jp112sdl/WemosD1_HomeMatic_Helligkeitssensor/Images/CCU_VariableNeu.png

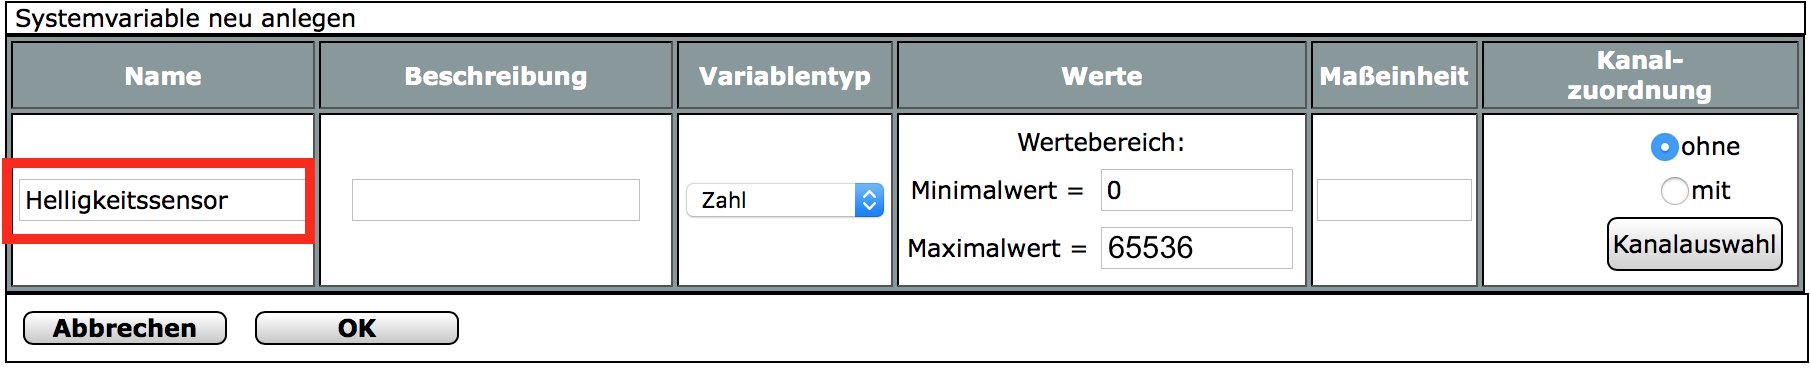
Images/CCU_VariableNeu.png
