jp112sdl/WemosD1_HomeMatic_Helligkeitssensor/(threads)

Thread 1 (2018-02-01):

WemosD1 HomeMatic mit Bmp180 Luftdruck (&Temperatur)

elbman, 2018-02-01:
Hallo,

finde dein WemosD1 Projekt mit BH1750 Helligkeitssensor über I2C genial und habe es bereits nachgebaut.

Perfekt wäre es, wenn es alternativ auch eine Version für den Luftdruck- und Temperatursensor BMP180 gäbe.

Die Info über den aktuellen Luftdruck fehlt vielen in der Homematic noch bei den Wetterdaten und lässt sich ja leider nicht als einzelner Sensor von Homematic erwerben.

Über den Arduino mit LAN Shield gibt es hier einen Vorschlag aber mit dem WemosD1 wäre es dann doch einige Nummern besser

https://homematic-forum.de/forum/viewtopic.php?t=19900

Freue mich über deine Einschätzung

jp112sdl, 2018-02-01:
Hallo,

die hier vorgestellten Projekte sind so wie sie sind... und sie sind OpenSource, so dass sich jeder daran bedienen und sie weiter entwickeln oder nach persönlichem Bedarf anpassen kann.

Den Luftdrucksensor anzuschließen sollte kein Problem sein. Er wird einfach parallel zum BH1750 geklemmt... Ist ja I²C Bus.

Das Problem ist nur: Wenn ich den Sensor hier mit integriere, möchte der nächste gern beim Temp-/Feuchtesensorprojekt mit drin haben, oder irgendwo anders.

jp112sdl, 2018-02-01:
P.S.: Wenn du den BME280 nimmst, hast du gleich noch Temperatur und Luftfeuchte.

elbman, 2018-02-02:
Danke, das verstehe ich. Werde mich bei Zeiten da mal reinarbeiten

jp112sdl, 2018-02-02:
@elbman
Ist nicht böse gemeint, aber man kommt sonst vom Hundertsten zum Tausendsten ;)

Viel Erfolg!

Closed 2018-12-22.

Thread 2 (2018-03-30):

Fehler beim flashen

lukashauck89, 2018-03-30:
Mal ne Frage funktioniert das flashen mit dem Grafiktool unter win10 nicht? Zeigt am Ende immer "Failed To write To target flash" an. Gruß Lukas

jp112sdl, 2018-03-30:
Das kann ich dir leider nicht beantworten, da ich kein Windows nutze.

Schau mal hier, direkt beim ESP-Hersteller, da gibts auch ein [Tool](https://www.espressif.com/en/support/download/other-tools)

lukashauck89, 2018-03-30:
Hab es mit dem Tool getestet zeigt keinen Fehler. Komme aber nicht in den WLAN Konfig Modus. Habe nicht den Orginal wemos Baustein. Vielleicht liegt es daran. AZDelivery D1 Mini NodeMcu Lua ESP8266 ESP-12E WLAN WIFI Internet Module Entwicklungsboard für Arduino, 100% kompatibel mit WeMos D1 Mini https://www.amazon.de/dp/B01N9RXGHY/ref=cm_sw_r_cp_apa_lkQVAbM6NY749

jp112sdl, 2018-03-30:
Taster an D7 gedrückt halten und Stromzufuhr herstellen... klappt nicht?

lukashauck89, 2018-03-30:
Nein Led Blitz einmal wie immer dann nichts mehr.

jp112sdl, 2018-03-30:
Dann lass dir mal mit Putty oder einem anderen Terminalprogramm die seriellen Log-Ausgaben (115200 Baud) anzeigen.

lukashauck89, 2018-03-30:
{ll▒▒<▒l▒|
▒
d▒
#|▒▒▒▒{▒c▒
#▒▒gn▒lno▒▒▒
cp▒▒dsd;l{▒n▒c▒ncp

lukashauck89, 2018-03-30:
das spuckt er beim reset aus

jp112sdl, 2018-03-30:
Das ist nix... da läuft nix auf dem Wemos.
Dann ist beim Flashen was schiefgegangen oder so.

Da muss lesbarer Text kommen.

lukashauck89, 2018-03-30:
Dacht ich mir.
so sieht der verlauf aus:
connecting ....
Erasing flash...

Writing at 0x00000000... (0 %)

Writing at 0x00000400... (3 %)

Writing at 0x00000800... (6 %)

Writing at 0x00000c00... (9 %)

Writing at 0x00001000... (12 %)

Writing at 0x00001400... (15 %)

Writing at 0x00001800... (18 %)

Writing at 0x00001c00... (21 %)

Writing at 0x00002000... (24 %)

Writing at 0x00002400... (27 %)

Writing at 0x00002800... (30 %)

Writing at 0x00002c00... (33 %)

Writing at 0x00003000... (36 %)

Writing at 0x00003400... (39 %)

Writing at 0x00003800... (42 %)

Writing at 0x00003c00... (45 %)

Writing at 0x00004000... (48 %)

Writing at 0x00004400... (51 %)

Writing at 0x00004800... (54 %)

Writing at 0x00004c00... (57 %)

Writing at 0x00005000... (60 %)

Writing at 0x00005400... (63 %)

Writing at 0x00005800... (66 %)

Writing at 0x00005c00... (69 %)

Writing at 0x00006000... (72 %)

Writing at 0x00006400... (75 %)

Writing at 0x00006800... (78 %)

Writing at 0x00006c00... (81 %)

Writing at 0x00007000... (84 %)

Writing at 0x00007400... (87 %)

Writing at 0x00007800... (90 %)

Writing at 0x00007c00... (93 %)

Writing at 0x00008000... (96 %)

Writing at 0x00008400... (100 %)
Failed to write to target Flash

lukashauck89, 2018-03-31:
Die Standart Baudrate ist wohl 7400 da zeigt er auch was an.

jp112sdl, 2018-03-31:
Hmm, da bin ich echt raus...
Noch nie gesehen sowas.

Evtl im Flash Tool eine falsche Clock Rate eingestellt, oder der Wemos hat tatsächlich ein Problem.

lukashauck89, 2018-03-31:
Welche Clock Rate wird benutzt? Ich werde wohl mal noch einen neuen D1 mini bestellen. Danke

jp112sdl, 2018-03-31:
Hab mir den Kram mal in eine virtuelle Windows-Umgebung geladen.

Probier es mal mit diesen Einstellungen, damit ging es bei mir. COM1 muss natürlich noch geändert werden.
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

Putty:
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

lukashauck89, 2018-03-31:
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

lukashauck89, 2018-03-31:
So sieht es dann aus aber funktionieren tut es nicht. Flash ist immernoch leer

jp112sdl, 2018-03-31:
Hast du irgendwas an D3 angeschlossen?

lukashauck89, 2018-03-31:
Nur die Brücke auf GND zum flashen

jp112sdl, 2018-03-31:
Aber auch wirklich nur zum Flashen?

Mit der Brücke startet der Wemos nicht... und geht immer wieder in den Flash-Modus.

Was auch deinen wirren Zeichensalat erklärt.

lukashauck89, 2018-03-31:
ja habe sie nur zum flashen drann

jp112sdl, 2018-03-31:
Ist auch eigentlich nur beim ESPFlasher notwendig. Mit dem Tool von Espressif brauchst du die Brücke nicht.

Hmm - also ich kann dir von hier sonst auch keine Tipps weiter geben.

lukashauck89, 2018-03-31:
Ok ich danke dir für deine mühe ich werden mal einen neuen bestellen. Hab von einem Käufer gelesen das er es auch mal hatte das sich einer einfach nicht flashen lies.

jp112sdl, 2018-03-31:
Ich mache kaum noch was mit den Wemos, aber ich hatte meine damals über eBay aus China bezogen, für irgendwas ~ 3 EUR pro Stück.
Siehe zB diesen [Artikel](https://www.ebay.de/itm/ESP8266-ESP-12-NodeMcu-Lua-WeMos-D1-Mini-WiFi-Develop-Kit-Development-Board-/272271662681)

Hab hier noch so ca. 15 Stück im Einsatz und hatte noch nie Probleme beim Flashen.

Ansonsten kann ich dir empfehlen, den [HM-Sen-LI-O](https://github.com/jp112sdl/Beispiel_AskSinPP/tree/master/examples/HM-Sen-LI-O) nachzubauen.
Den kannst du dann auch direkt in Homematic anlernen.
Allgemeine Verkabelungsübersicht und benötigte Teile findest du [hier](https://github.com/jp112sdl/Beispiel_AskSinPP).

Closed 2018-04-05.

Thread 3 (2019-09-05):

401 error if using this with curent firmware of ccu3

modwadd, 2019-09-05:
in the http request requires to be added :
Name:Passwort@ccuip
The Name and Password requires to be a valid user on the CCU.
Would be nice if this could be configured via web config in setup mode.

jp112sdl, 2019-09-05:
Sorry... since using AskSinPP Lib to create devices that can be used in Homematic natively I do not support the WiFi projects any longer.
https://asksinpp.de

Closed 2019-09-05.
